Vincentddl/AerialRoboArm/Doc/hardware/JY61P_DIAGNOSTIC.md

# JY61P 独立诊断（2026-10-24）

## 2026-10-27 再次恢复 200Hz 的测试

后续用户拔下模块完成空载 PB6 测试，再重新连接后复测已恢复：9600 下只读查询得到一个有效应答，PB6 采样高 2018 次、低 2457 次、22 次变化。随后分步切到 115200，设置三类输出和 200Hz、98Hz 带宽，各流实测约 200～201Hz，校验和 UART 恢复均为零。日志：`outputs/jy61p_diagnostic/recover_200hz_reconnected_20261027.txt`。此时仍为独立诊断固件，尚未执行 EEPROM 保存或断电保持验证。下面为此次恢复前的失败记录。

用户要求单独测试能否恢复 200Hz。独立诊断固件烧录校验成功，HX8 不发送运动指令。

- 9600 下三类数据约 10Hz，无解析校验错误，无 UART 接收恢复。
- 只读寄存器查询完成发送，但 PB6 软件采样为 `high=4416 low=0 edges=0`，无有效寄存器应答。
- 显式尝试解锁、修改 BAUD=6 后，115200 下无有效数据、UART 恢复增加；诊断程序退回 9600，三类数据恢复约 10Hz。
- 本次没有恢复到 200Hz，没有发送保存/校准/零点指令。不能把 `sent=1` 当作配置成功。

日志：`outputs/jy61p_diagnostic/recover_200hz_20261027.txt`。现象与此前连接负载下 PB6 读回全高相似，当前供电方式正在向用户核实。尚未完成受控供电对照，因此不能唯一归因于电池或连接器。

## 最新复测：2026-10-25 已恢复

用户将模块换回 JY61P 后重测：9600 下三个数据流各 10Hz、无校验和 UART 恢复错误。硬件只读查询时 PB6 采样高 1955 次、低 2457 次、22 次变化，收到一个校验正确的寄存器应答，双向通信成立。

随后分步配置：115200 切换成功（仍为 10Hz）；仅 ACC/GYRO/ANGLE 输出配置成功；200Hz 设置后分别实测 200/201/200Hz；98Hz 带宽设置后为 200/200/200Hz，校验错误和 UART 恢复均为零。短时监测保持约 200Hz。

日志：`jy61p_replaced_scan_20261025.txt`、`jy61p_replaced_query_20261025.txt`、`jy61p_replaced_config_20261025.txt`。此前的外部拉高现象在本次连接状态下已不再出现，更支持接线/连接状态相关的问题；无法仅凭重插、换模块后的恢复断定最初的具体故障件。未执行 EEPROM 保存或断电保持验证。板上仍是独立诊断固件。

## 实机结果

- 只读扫描发现实际模块处于 **9600、10Hz**。每秒加速度、角速度、角度各 10 包，校验错误和 UART 接收恢复均为零。
- 115200 没有有效包，并出现频繁 UART 错误恢复。不能将这种状态简单等同于模块没有供电。
- 从 9600 发送解锁和 BAUD=6 指令，MCU 的发送接口返回成功，但 115200 没有有效反馈。切回 9600 可继续读取。
- 在 9600 发送无需解锁的寄存器查询，仍未收到预期校验正确的 0x55/0x5F 应答。

因此传感器到 MCU 的接收链路能工作；优先检查 **PB6/USART1_TX → 模块 RX** 的线序、接触和连续性。也可能是模块版本/协议或配置命令的生效方式，尚不能通过当前数据唯一定位，更不能断言模块已坏。供电在读取期间至少能维持传感器输出，但没有实测其电压及压降。

原始日志见 `outputs/jy61p_diagnostic/passive_scan_fixed.txt`、`config_steps.txt`、`register_query.txt`。其中早期诊断中错误波特率下的伪数据已在后续诊断中排除，不作为有效输出率。

## 诊断程序

独立构建 `cmake-build-jy61p-diagnostic`，配置 `HX8_JY60_CAPTURE=ON JY61P_CAPTURE=ON JY61P_DIAGNOSTIC=ON`。复用初始化和 USART1 DMA，但不进入 HX8 轮询或运动命令处理，不输出 PWM。RTT 9090 显示 `[DIAG]`，普通联合采集脚本应停止。

- `r`：只读扫描各波特率；候选必须无校验错误且无 UART 恢复，避免错误波特率下的伪匹配。
- `q`：在当前波特率查询寄存器并统计 0x5F 应答。
- `c`：明确触发分步配置；若新波特率不能确认则恢复本地主机 9600，不发送舵机命令。

当前板上为诊断固件，不接受 `g` 运动指令。恢复联合测试需要重新烧录 `cmake-build-hx8-jy61p-capture` 对应固件。

## 软件问题修正

排查同时发现，UART 错误中断重启 DMA 时，前台读函数可能用旧游标覆盖刚重置的接收游标。已增加恢复代数检查，丢弃发生这种竞争时的旧数据。联合固件启动扫描现在还检查 UART 恢复及校验错误，并实际确认波特率、速率，失败会打印明确原因并退回已识别波特率。过去 `sent=1` 仅代表发送成功，不能证明配置成功。

检查接线时先断电：确认主板原 ELRS 4 脚/PB6 到 JY61P RX 导通，3 脚/PB7 到 JY61P TX；不要把模块板上引脚序号与主板插座序号混为一谈。必要时用逻辑分析仪同时测 MCU PB6 与模块 RX，区分“没有发送波形”和“波形没送到模块”。

## 进一步双向通信实测

日志：`outputs/jy61p_diagnostic/bidirectional_test.txt` 和 `software_tx_test.txt`。

- 三次硬件 UART 只读查询，发送完成，但对 PB6 输入电平的高速软件采样均为 `tx_pin_low=0 tx_pin_edges=0`，无有效寄存器应答。
- USART1 的 PB6 AF 推挽配置和重映射寄存器读值与预期一致：GPIOB CRL `0x4B484444`、AFIO MAPR `0x02000004`、9600 的 BRR `0x1D4C`。
- 增加 `b` 命令：仅在本地 9600 下，将 PB6 暂时切到 GPIO 推挽，使用 DWT 周期计时发送同一个只读查询，再恢复 GPIO/USART 配置，不发送舵机指令。
- 两次 GPIO 模拟查询，每次 50 位中读到高电平 50 次、低电平 0 次，28 个要求为低的位读回不符；仍无寄存器应答。

上述是 MCU 数字输入读回结果，不是示波器波形或实际电压测量。优先怀疑 PB6 被外部拉高、接错引脚/短接，或主板引脚/配置异常。不能单凭本次结果断言 JY61P 损坏。

下一步：断电后仅断开 PB6→JY61P RX 线，保留传感器供电与 TX→PB7。重新上电，重复 PB6 查询测试。若低电平恢复，应优先排查外部线序、插座或模块 RX 端；若仍读回全高，应进一步检查 PB6 主板引脚、其他并接线路和 GPIO 配置，再决定是否更换硬件。此断线对照截至当前尚未完成。

## 整体插头拔下后的对照结果

用户说明连接器为一体座，无法单拆 RX 线，随后确认整个插头已拔下。新诊断 `p` 暂停 USART1，在 PB6、PB7 上依次输出高/低/高，再恢复原配置；无舵机控制。

- GPIOB 锁定寄存器为 0；PB6 和 PB7 输出配置均成功读回为推挽 GPIO `mode=0x3`。
- 两个引脚都得到 `expected=1 odr=1 idr=1` → `expected=0 odr=0 idr=0` → `expected=1 odr=1 idr=1`。
- 恢复 USART1 后，再发空载硬件串口查询，PB6 软件采样得到高 167 次、低 199 次、22 次边沿变化。外设配置下也能看到输出变化。

日志为 `unloaded_pin_test.txt`、`unloaded_uart_tx.txt`。与接上整只插头时 PB6 一直为高形成明确对照，优先定位外部线束、连接器线序或模块 RX 端的负载/短接问题。空载测试不能完全排除引脚带载能力异常，也不能单独区分线束与模块损坏；不应直接宣称 JY61P 芯片已坏。

下一步应断电核对主板原 ELRS 第 4 脚是否确实连接模块 RX，而非 VCC 或模块 TX。整个模块当前拔下，显示 0Hz 是预期现象；只有重新正确连接后才继续模块通信验证。
