Vincentddl/AerialRoboArm/Doc/design/05_HX8_OUTPUT_CURVE_PLAN.md

# HX8 主臂出力与运动曲线方案

## 适用范围与边界

本方案针对 HX8-U26H-M 经 UC-01 驱动主臂的单圈位置控制。当前项目的软件角度范围为 `-90°..+85°`，CH1 手动目标速度上限为 `150°/s`，发给舵机的速度上限为 `220°/s`，加减速时间各 `100 ms`。以下数值是**离线起始曲线**，尚未按实际负载标定，也未写入舵机。

厂家在 12 V 条件下给出的参考值：额定扭矩 `0.44 N·m`、最大连续扭矩 `1.18 N·m`、瞬时堵转扭矩 `2.55 N·m`、峰值电流 `5.5 A`；输入电压范围 `9.0..12.6 V`。连续持载以额定扭矩作为初始设计目标，堵转扭矩仅用于理解短时极限。

## 1. 先算负载，再选曲线

在机械臂最不利姿态估算关节静态扭矩：

`τ_joint ≈ 9.81 × Σ(质量_kg × 到转轴的水平距离_m)`。

若舵机与主臂之间的外部齿轮确为主动 `40` 齿、从动 `48` 齿，则初估舵机所需扭矩为 `τ_servo ≈ τ_joint / (1.2 × η)`；`η` 是传动效率，需结合装配实测。齿轮主动/从动方向、臂杆自重与负载重心必须确认后，才能给出可靠的负载上限。

## 2. 建议的速度—位置曲线

定义朝正角限位运动时 `d = 85° - 当前位置`，朝负角限位运动时 `d = 当前位置 + 90°`，即到目标方向软件限位的剩余角度；`u` 为 CH1 超过 `10%` 死区后归一化到 `0..1` 的幅度。先用下面两条曲线作为调试起点：

`v_空载 = min(150u, √(2 × 600 × d))  °/s`

`v_满载 = min(120u, √(2 × 400 × d))  °/s`

其中 `600` 和 `400` 的单位为 `°/s²`，是**计划中的保守减速能力**，须通过实测修正。目标方向指向限位时应用剩余距离 `d`；离开限位时按摇杆请求速度逐步加速。到 `d=0` 时速度命令为零，不再累积目标。舵机自身仍使用速度受限的位置指令，初期保持 `100 ms` 加速和 `100 ms` 减速。

| 距同侧限位 `d` | ≥20° | 10° | 5° | 2° | 0° |
| --- | ---: | ---: | ---: | ---: | ---: |
| 空载满杆上限 | 150 | 110 | 77 | 49 | 0 |
| 满载满杆上限 | 120 | 89 | 63 | 40 | 0 |

表中单位均为 `°/s`，只表示控制器的速度上限，不代表实测电机速度。若负载使跟踪误差持续增大，应降低该姿态的目标速度，而非让目标继续积累。

## 3. 功率与扭矩包络

当前运动指令的 `power_mw=0`，按厂家协议会采用舵机内部设定的功率保护值。此时把指令里的功率字段调大，不能越过内部保护值。先保持舵机原有保护设置，测得以下曲线后再决定是否要改：

- `P_hold(θ)`：不同角度连续保持时的功率，第 95 百分位值；
- `P_move(θ,v)`：不同角度和速度移动时的功率，第 95 百分位值；
- `I_peak(θ,v)`、`V_min(θ,v)`：加速与换向期间的峰值电流和最低电压；
- `e(θ,v)`：目标与编码器角度的跟踪误差。

若要为已知负载建立**低于舵机保护值**的运行功率包络，可从 `P_cmd(θ,v) = min(P_保护, 1.25 × P95_需求(θ,v))` 起步，并确认保持、启动和换向都能完成。`1.25` 是初始裕量，实际值由重复试验决定。任何温度、电流、功率或堵转保护触发时，停止运动并排查原因；不要仅靠提高保护阈值消除报警。需要提高舵机内部保护值时，先确认电源、线材、机构和连续热负荷承受能力，并查明原始配置及厂家允许范围。

## 4. 标定试验与验收

1. 分别以空载、预期负载的 50%、100% 试验；从小角度、小速度开始，确认机构无干涉。
2. 在 `-80°、-40°、0°、+40°、+80°` 附近分别做保持与往返运动，每种条件重复至少 5 次。暂不在负载下反复撞击 `-90°/+85°` 软件限位。
3. 记录至少 `10 Hz` 的编码器角度、目标角度、电压、电流、功率、温度原始值和状态位；短时电流峰值需用独立电流测量设备复核，因为 `10 Hz` 回读可能漏掉尖峰。
4. 在最不利的水平持载姿态连续保持至少 5 分钟，观察温升、位置下垂和电源压降。
5. 第一轮验收：全程电压处于 `9.0..12.6 V`，无堵转、欠压、过流、过功率、过温状态；稳态角度误差以 `≤2°` 为初始目标，且回中后目标不再继续积累。任何指标失败，都回到更低的速度或更小的负载重新标定。

最终曲线应以这组实测数据更新：将满足位置误差与温升要求的最大速度作为该角度、负载下的上限；功率配置只覆盖所需扭矩并保留可验证的裕量。没有负载质量、力臂和实测功率数据时，本文件中的数值不能作为已验证的出力承诺。

## 资料

- Fashion Star HX8-U26H-M 产品规格：<https://fashionstar.com.hk/wiki/uart-servo/hx8-u26h-m/>
- Fashion Star UART/RS-485 协议、功率字段及保护参数：<https://fashionstar.com.hk/wiki/protocols/servo/uart-rs485/>
- 项目当前限位与控制参数：`User/global/Inc/ara_def.h`、`User/mod/Inc/mod_rc_semantic.h`、`User/task/Inc/task_motion.h`。
