Vincentddl/AerialRoboArm/Doc/design/00_SYSTEM_CONSTITUTION.md

# docs/design v0

> **Archive note:** This design document belongs to the older BLDC/AS5600
> architecture narrative. It is kept for thesis/history reference only. The
> current hardware bring-up is documented in `Doc/hardware/pinmap.md`.

## 00_SYSTEM_CONSTITUTION.md

# AerialRoboArm 顶层宪法 v1.0

## 1. 文档定位
本文件是 AerialRoboArm（ARA）项目的顶层设计宪法。

本文件用于定义项目的第一身份、系统愿景、责任边界、控制主权与不可轻易违背的宏观设计原则。其目标不是描述某一版本的实现细节、模块完成度或阶段性进度，而是为后续架构设计、模块实现、状态机细化、接口收敛、联调验收与论文表述提供统一的上位依据。

凡属短期可变的版本状态、具体实现路径、暂定参数、阶段性工程负债与模块完成度，不应进入本文件正文，而应由运行时架构文档、模块契约文档、状态机文档、接口协议文档与版本说明文档承接。

## 2. 项目第一身份
ARA 的第一身份是**本科毕业设计样机**。

本项目首先服务于一套机载机械臂控制样机的设计、联调、验证与答辩表达，而非以通用机器人控制平台或成熟产品化控制器为直接目标。项目的一切架构选择，均应优先服从“样机可成立、主链路可联调、系统表述自洽、验证路径清晰”这一首要任务。

在此基础上，项目可以保留有限的可演进性，但这种可演进性是对样机价值的补充，而不是取代样机目标本身。

## 3. 项目愿景
ARA 旨在构建一套面向机载环境的轻量化机械臂控制子系统，在资源受限 MCU 上实现可运行、可观测、可联调、可实机验证的控制系统骨架。

该系统面向空中抓取类任务场景，试图在“平台载荷重量敏感”与“末端抓取动作对控制精度和响应速度提出较高要求”之间，建立一个工程上可成立的折中方案。系统以 STM32 为实时控制核心，以 BLDC 主轴闭环控制为动力基础，以舵机执行器承担末端姿态与夹取动作，以 RC 人工接管与视觉语义输入作为上层行为入口，形成一套在资源、时序、接口与业务逻辑上自洽的机载控制样机。

本项目当前不以复杂智能规划、整机飞控协同闭环或完整产品化鲁棒性为首要目标，而以建立一个“控制主链路清晰、系统边界明确、运行节拍可预测、调试与答辩可解释”的工程原型为首要目标。

## 4. 系统边界

### 4.1 系统性质
ARA 是**机载机械臂控制子系统**，不是无人机整机总控系统。

本系统负责机械臂相关的执行控制、模式管理、局部自治决策、RC 接管响应与视觉语义解释；本系统不负责飞行姿态控制、飞行航迹规划、平台接近目标的导航闭环与无人机整机级状态管理。

### 4.2 上游平台前提
ARA 默认挂载于一个能够维持基本稳定飞行状态的上游飞行平台上。平台接近目标、空中悬停稳定与基础姿态控制属于上游系统前提，而非本系统的直接闭环责任。

### 4.3 感知边界
视觉与测距系统的内部实现细节不属于本电控系统的职责边界。对于 ARA 电控系统而言，感知链路最终应被抽象为**统一扩展链路上的最终语义事件输入**。系统不依赖单目视觉、ToF、深度估计或融合算法的内部实现过程，而只依赖它们最终输出的、对机载决策直接有意义的紧凑语义结果。

### 4.4 决策边界
PC/地面端或其上的感知系统负责环境感知与事件计算；机载 STM32 负责结合本机当前模式、主轴状态与业务状态机，完成最终动作决策与执行控制。感知端不直接承担执行器闭环控制职能。

## 5. 控制主权与模式哲学

### 5.1 控制主权分配
ARA 的控制主权分配遵循以下原则：
- RC 是人工接管入口，具备最高即时接管优先级；
- 视觉链路是环境语义输入入口，不直接拥有执行器闭环控制权；
- STM32 是机载最终决策与执行节点，负责在当前模式约束下将输入语义转化为动作输出。

### 5.2 Manual 模式
在 MANUAL 模式下，自动决策逻辑必须挂起。系统允许视觉事件继续接收与更新，但视觉信息在该模式下不作为动作主导来源。此时系统的主轴、姿态与夹爪动作均以 RC 语义输入为唯一有效控制来源。

### 5.3 Auto 模式
在 AUTO 模式下，系统接收由感知链路回传的最终视觉语义事件，并由机载 STM32 结合当前自身状态完成动作决策。AUTO 模式的目标是实现**受监督的局部自治**，而不是构建脱离人工接管能力的完全自主系统。

### 5.4 模式优先级
凡 RC 接管、急停请求或系统关键模式转换与 AUTO 业务状态机发生冲突时，应优先服从人工接管与系统安全相关的高优先级约束。

## 6. 宏观设计原则

### 6.1 资源约束优先
一切设计必须首先服从 STM32F103C8T6 的 RAM、算力、定时器、DMA、串口与总线资源边界。任何为追求形式上的架构完整性而破坏资源可承受性的设计，都应被视为无效设计。

### 6.2 时序确定性优先
系统必须优先保证控制链路的运行时可预测性。高频控制路径不得因阻塞式 IO、复杂日志格式化、动态资源竞争、跨模块隐式依赖或不受控的多线程交互而失去确定性。

### 6.3 分层与职责单一
系统采用分层设计。每一层只承担与其层级相称的职责：
- 底层负责外设与硬件抽象；
- 中层负责驱动、算法与功能模块封装；
- 任务层负责业务 runnable 与状态机；
- 顶层负责物理线程容器与系统调度。

任何跨层越权行为，若会破坏职责边界，应被视为架构退化。

### 6.4 单向数据流优先
高频控制域与低频业务域之间的跨线程信息交换，必须通过统一的数据桥梁完成。业务模块之间不应通过横向读取彼此内部状态形成隐式耦合。系统应优先维持“输入—决策—执行—反馈”的清晰方向性。

### 6.5 语义先于实现
任何关键术语在进入代码实现前，必须先具有稳定且唯一的设计语义。例如：系统模式、动作目标、急停、对齐、归位、机械原点、电角参考、抓取判据等概念，必须先在设计层定义，再在实现层映射。

### 6.6 紧凑语义优先于原始数据堆积
统一扩展链路优先承载对机载控制决策直接有意义的紧凑语义结果，而非大规模原始感知数据。任何外部输入若不能被压缩为对控制链路直接有用的事件或参数，就不应直接进入核心控制体系。

## 7. 控制对象划分原则
ARA 的控制对象分为两类：

### 7.1 高频闭环对象
BLDC 主轴是当前系统唯一的高频闭环执行对象。与主轴位置、速度、对齐、归位和闭环控制相关的控制逻辑，应被视为系统动力核心。

### 7.2 低频直控对象
夹爪舵机与姿态舵机属于低频直控执行对象。它们承担末端动作与姿态调节功能，但不构成当前版本的统一高频闭环控制核心。

这一划分是系统资源约束与任务目标共同作用下的工程选择，而非临时性的实现妥协。

## 8. 当前阶段的战略目标
当前阶段的战略目标是：**优先建立 Happy Path 可成立、主链路可联调、样机行为可解释的控制系统原型。**

这意味着，当前阶段优先验证以下方面：
- 核心控制架构是否成立；
- 主轴控制链路是否能够完成对齐、归位、闭环与手动控制；
- Manual / Auto 模式切换与控制主权分配是否自洽；
- 感知语义输入到动作输出的主业务流是否可联调；
- 系统在答辩与工程表述上是否具有清晰的结构与边界。

当前阶段不以完整异常流覆盖、产品级容错体系、复杂自主规划能力或全链路产品化成熟度作为首要验收目标。

## 9. 非目标声明
在当前阶段，下列方向不作为首要设计目标：
- 无人机整机级飞控闭环与导航协同；
- 高自由度多执行器统一高频闭环；
- 完整产品化高可靠容错与恢复体系；
- 对感知算法内部细节的深度耦合；
- 脱离人工接管能力的完全自主抓取系统。

上述方向在后续研究或扩展中可被讨论，但不构成本文件所约束的当前项目核心目标。

## 10. 文档优先级
当不同文档、注释或临时讨论之间出现冲突时，应遵循以下优先级：
1. 顶层宪法；
2. 运行时架构、模块契约、状态机、接口协议等正式设计规范；
3. 代码头文件注释；
4. 分支说明、阶段复盘、开发记录；
5. 临时讨论结论。

凡与本宪法冲突的实现细节、临时约定或局部设计，应以修正实现或补充正式设计文档为优先，而不应反向削弱顶层原则。
