Vincentddl/AerialRoboArm/Core/Src/main.c

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
/* Includes ------------------------------------------------------------------*/
#include "main.h"
#include "cmsis_os.h"
#include "dma.h"
#include "i2c.h"
#include "iwdg.h"
#include "tim.h"
#include "usart.h"
#include "gpio.h"

/* USER CODE BEGIN Includes */
#include "bsp_uart.h"
#include "bsp_gpio.h"
#include "bsp_pwm.h"

/* demo_v7 app-layer entries */
#include "app_control.h"
#include "app_debug.h"
#include "app_jy60_demo.h"
#include "app_hx8_jy60_capture.h"

/* USER CODE END Includes */


void SystemClock_Config(void);
void MX_FREERTOS_Init(void);
/**
  * @brief  The application entry point.
  * @retval int
  */
int main(void)
{

  /* MCU Configuration--------------------------------------------------------*/

  /* Reset of all peripherals, Initializes the Flash interface and the Systick. */
  HAL_Init();

  /* Configure the system clock */
  SystemClock_Config();

  /* Initialize all configured peripherals */
#if defined(HX8_JY60_CAPTURE)
  MX_GPIO_Init();
  MX_DMA_Init();
  MX_USART1_UART_Init();
  MX_USART2_UART_Init();
  MX_IWDG_Init();
  App_Hx8Jy60Capture_Run();
#elif defined(JY60_UART_DEMO)
  /* Sensor-only path: no PWM, HX8 UART, HC13, control tasks or homing. */
  MX_GPIO_Init();
  MX_DMA_Init();
  MX_USART1_UART_Init();
  MX_IWDG_Init();
  App_Jy60Demo_Run();
#else
  MX_GPIO_Init();
  MX_DMA_Init();
  MX_I2C1_Init();       /* PB8/PB9 sensor bus; VL53L1X uses address 0x29. */
  MX_USART3_UART_Init();  /* HC13 transparent UART on PB10/PB11. */
  MX_TIM2_Init();
  MX_USART1_UART_Init();
  MX_USART2_UART_Init();
  MX_IWDG_Init();
  /* USER CODE BEGIN 2 */
    BSP_UART_Init(); // 确保串口先初始化，方便打印 Log
#if !defined(TOFSENSE_SAFE_TEST)
    /* Sensor-only validation must not start either PTK PWM output. */
    BSP_PWM_Init();
#endif

    /* PB8/PB9 provide the I2C1 sensor bus. */

    /* demo_v7: bring up app-layer dependencies before kernel starts. The
     * actual ControlTask / DebugTask are created from RTOS_THREADS in
     * freertos.c. */
    App_Control_InitDeps();
    App_Debug_InitDeps();

  /* USER CODE END 2 */

  /* Init scheduler */
  osKernelInitialize();  /* Call init function for freertos objects (in cmsis_os2.c) */
  MX_FREERTOS_Init();

  /* Start scheduler */
  osKernelStart();

  /* We should never get here as control is now taken by the scheduler */

  /* Infinite loop */
  /* USER CODE BEGIN WHILE */
  while (1)
  {
    /* USER CODE END WHILE */

    /* USER CODE BEGIN 3 */
  }
  /* USER CODE END 3 */
#endif
}

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
/**
  * @brief  Period elapsed callback in non blocking mode
  * @note   This function is called  when TIM4 interrupt took place, inside
  * HAL_TIM_IRQHandler(). It makes a direct call to HAL_IncTick() to increment
  * a global variable "uwTick" used as application time base.
  * @param  htim : TIM handle
  * @retval None
  */
void HAL_TIM_PeriodElapsedCallback(TIM_HandleTypeDef *htim)
{
  if (htim->Instance == TIM4)
  {
    HAL_IncTick();
  }
}

/**
  * @brief  This function is executed in case of error occurrence.
  * @retval None
  */
void Error_Handler(void)
{
  /* USER CODE BEGIN Error_Handler_Debug */
  /* User can add his own implementation to report the HAL error return state */
  __disable_irq();
  while (1)
  {
  }
  /* USER CODE END Error_Handler_Debug */
}
#ifdef USE_FULL_ASSERT
/**
  * @brief  Reports the name of the source file and the source line number
  *         where the assert_param error has occurred.
  * @param  file: pointer to the source file name
  * @param  line: assert_param error line source number
  * @retval None
  */
void assert_failed(uint8_t *file, uint32_t line)
{
  /* USER CODE BEGIN 6 */
  /* User can add his own implementation to report the file name and line number,
     ex: printf("Wrong parameters value: file %s on line %d\r\n", file, line) */
  /* USER CODE END 6 */
}
#endif /* USE_FULL_ASSERT */
