Vincentddl/AerialRoboArm/standalone/vl53l3cx_f103/App/Inc/app_config.h

#ifndef APP_CONFIG_H
#define APP_CONFIG_H

#define VL53L3CX_I2C_ADDRESS_8BIT 0x52U
#define SENSOR_I2C_CLOCK_HZ 400000U
#define VL53L3CX_POLL_PERIOD_MS 2U
#define VL53L3CX_RETRY_PERIOD_MS 1000U
#define VL53L3CX_PRINT_DECIMATION 1U

#define DEBUG_UART_BAUDRATE 115200U
#define DEBUG_UART_TIMEOUT_MS 100U

#endif
