Vincentddl/AerialRoboArm/standalone/vl53l3cx_f103/Core/Inc/i2c.h

#ifndef __I2C_H
#define __I2C_H

#ifdef __cplusplus
extern "C" {
#endif

#include "main.h"

extern I2C_HandleTypeDef hi2c1;

void MX_I2C1_Init(void);

#ifdef __cplusplus
}
#endif

#endif /* __I2C_H */
