Vincentddl/AerialRoboArm/standalone/vl53l3cx_f103/Core/Inc/usart.h

#ifndef __USART_H
#define __USART_H

#ifdef __cplusplus
extern "C" {
#endif

#include "main.h"

extern UART_HandleTypeDef huart2;

void MX_USART2_UART_Init(void);

#ifdef __cplusplus
}
#endif

#endif /* __USART_H */
