Vincentddl/AerialRoboArm/standalone/vl53l3cx_f103/Core/Src/gpio.c

#include "gpio.h"
#include "main.h"

void MX_GPIO_Init(void)
{
    GPIO_InitTypeDef GPIO_InitStruct = {0};

    __HAL_RCC_GPIOC_CLK_ENABLE();
    __HAL_RCC_GPIOA_CLK_ENABLE();
    __HAL_RCC_GPIOB_CLK_ENABLE();

    HAL_GPIO_WritePin(LED_GPIO_Port, LED_Pin, GPIO_PIN_SET);
    HAL_GPIO_WritePin(VL53_XSHUT_GPIO_Port, VL53_XSHUT_Pin, GPIO_PIN_RESET);

    GPIO_InitStruct.Pin = LED_Pin;
    GPIO_InitStruct.Mode = GPIO_MODE_OUTPUT_PP;
    GPIO_InitStruct.Speed = GPIO_SPEED_FREQ_LOW;
    HAL_GPIO_Init(LED_GPIO_Port, &GPIO_InitStruct);

    GPIO_InitStruct.Pin = VL53_XSHUT_Pin;
    GPIO_InitStruct.Mode = GPIO_MODE_OUTPUT_PP;
    GPIO_InitStruct.Pull = GPIO_NOPULL;
    GPIO_InitStruct.Speed = GPIO_SPEED_FREQ_LOW;
    HAL_GPIO_Init(VL53_XSHUT_GPIO_Port, &GPIO_InitStruct);

    GPIO_InitStruct.Pin = VL53_GPIO1_Pin;
    GPIO_InitStruct.Mode = GPIO_MODE_INPUT;
    GPIO_InitStruct.Pull = GPIO_PULLUP;
    HAL_GPIO_Init(VL53_GPIO1_GPIO_Port, &GPIO_InitStruct);
}
