Vincentddl/AerialRoboArm/standalone/vl53l4cd_f103/App/Inc/app_config.h

#ifndef APP_CONFIG_H
#define APP_CONFIG_H

#define VL53L4CD_I2C_ADDRESS_8BIT 0x52U
#define SENSOR_I2C_CLOCK_HZ 400000U
#define VL53L4CD_TIMING_BUDGET_MS 20U
#define VL53L4CD_APP_INTERMEASUREMENT_MS 0U
#define VL53L4CD_POLL_PERIOD_MS 1U
#define VL53L4CD_RETRY_PERIOD_MS 1000U
#define VL53L4CD_PRINT_DECIMATION 1U

#define DEBUG_UART_BAUDRATE 115200U
#define DEBUG_UART_TIMEOUT_MS 100U

#endif
