Vincentddl/AerialRoboArm/(commit log)

2026-03-06 Improve FOC stability and fix test console encoding
    降低了编码器 I2C 读数在闭环下报 -2 / -10 的概率
    避免了日志打印干扰 PID 内部状态
    避免了闭环模式里反复初始化 PWM/驱动导致的抖动
    把 c 模式从过激设置改成更保守、可调试的状态
    修复了 FOC 波形查表 bug
    解决了 test_console.c 的中文注释乱码问题
    [i2c.c, test_console.c]
2026-03-06 完善I2C恢复逻辑并优化闭环测试流程
    完善 AS5600 的 I2C/DMA 错误恢复机制
    优化 test_console 模式切换与停机逻辑
    增加 Uq 斜坡控制并重新整定 2808 测试参数
2026-03-28 串口调试窗口（USART3, 115200 baud）无法输入任何字符，按键后控制台无响应。
    ### 根因分析
    **根因 1（主要）：UART 错误后 DMA 接收永久停止**
    STM32 HAL 在检测到 UART overrun 错误时，内部调用链
    `USART3_IRQHandler → HAL_UART_IRQHandler → UART_DMAError → HAL_DMA_Abort`
    会中止 DMA 传输并将 UART 状态置为 READY，导致 DMA 接收永久停止。
    项目中缺少 `HAL_UART_ErrorCallback`，错误发生后无任何恢复机制。
    **根因 2（次要）：命令需要换行符才触发**
    `ProcessConsoleByte` 只在收到 `\r`/`\n` 时才执行命令。使用 raw 模式终端时，按键只发送单字节（如 `0x7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
2026-05-06 修复电机 testbench 真实对齐与闭环方向
    本次修改修复电机 testbench 的 FOC 对齐和闭环控制路径，去掉硬编码零点，改为使用运行时真实对齐结果，并修正闭环力矩方向。
    改动内容：
    - 删除 app_testbench.c 中的硬编码 FOC 零点注入。
    原代码固定注入 TB_MOTOR_HARDCODED_ZERO_OFFSET = 887，并直接把 aligned 置为 true，导致系统跳过真实对齐。该固定值不匹配当前硬件位置，会导致 FOC 电角度错误。
    - 初始化时将电机状态设为未对齐。
    aligned 现在初始化为 false，闭环/开环在真实对齐完成前不会运行，避免使用无效零点进入控制。
    - 进入 slot 1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
    [app_testbench.c]
2026-05-14 feat(demo_v7): phase1 dual-link + ST3215 protocol skeleton
    Build a complete control stack for the dual-input ST3215 era while keeping
    the legacy BLDC code intact (excluded from build).
    L5 Application threads:
    - app_control: 50 Hz ControlTask, sole DataHub writer, with bring-up
    state machine (BOOT -> SERVO_PING -> SERVO_CONFIG -> SERVO_ENABLE
    -> RUNNING -> FAULT) and heartbeat for IWDG.
    - app_debug: 10 Hz console + LED renderer + DataHub snapshot dump.
    - app_housekeeping: 1 Hz, runs from defaultTask body, refuses to feed
    IWDG when ControlTask heartbeat is stale.
    L4 Task runnables:
    - task_arbiter: pure function E-Stop / MANUAL / AUTO / link-loss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
2026-05-14 chore(demo_v7): remove legacy BLDC/FOC stack
    Phase 1 build has been validated with these files excluded via CMake
    EXCLUDE REGEX. Now that the new ST3215 + Mock stack compiles and links
    cleanly at 14.2 KB RAM / 50.3 KB FLASH, the legacy files have no further
    reference and can be git-rm'd.
    Removed:
    User/mod/{alg_pid,alg_voltage_foc}.{h,c}
    User/drv/{drv_as5600,drv_bldc_power}.{h,c}
    User/bsp/{bsp_i2c}.{h,c}
    CMakeLists.txt: drop the matching EXCLUDE REGEX entries. Remaining
    EXCLUDEs (app_threads, app_testbench, test_console_drvtest) are kept
    for Phase 2, where their useful migration content moves into app_debug
    and ST3215-specific test slots before deletion.
    Resource (unchanged): RAM 142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
2026-05-14 chore(demo_v7): wire USART2 HD path after CubeMX regen
    CubeMX configuration update:
    - USART2 enabled at 1 Mbps Single Wire (Half Duplex), DMA TX=DMA1_Ch7,
    DMA RX=DMA1_Ch6, NVIC priority 5 (compatible with FreeRTOS
    configMAX_SYSCALL_INTERRUPT_PRIORITY).
    - IWDG enabled at LSI/64, reload 2812 (~4.5 s window). Feeds via
    app_housekeeping which gates on a fresh ControlTask heartbeat.
    - TIM1 disabled (3-phase PWM no longer used). I2C1 disabled
    (AS5600 path retired).
    - FreeRTOS heap synced to 5120 in .ioc (matches FreeRTOSConfig.h).
    - configCHECK_FOR_STACK_OVERFLOW = Method 2 enabled in .ioc.
    CubeMX regen reconciliation:
    - CMakeLists.txt: restore User/*.* glob and 6 User include roots
    tha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
    [FOC_DEMO2.ioc, bsp_pwm.c, bsp_pwm.h, bsp_uart.c, i2c.c, main.c, usart.c, usart.h]
2026-05-14 feat(demo_v7): wire torque_enable into real motion path
    Previously the real-servo path could only WritePos and ReadFeedback,
    so when the manipulator FSM commanded torque_on=true the servo would
    not actually exert force unless its TORQUE_ENABLE register happened
    to be set out-of-band.
    Changes (real path only, MOCK path untouched):
    - Add do_set_torque() built on do_write_byte() with the existing
    ACK parse path.
    - TaskMotion_Update now sequences set-torque BEFORE write-pos when
    cmd->torque_on disagrees with the cached s_torque_enabled flag.
    - If torque-enable IO fails, the WritePos call is suppressed for
    this tick; last_write_result carries the failure code upward.
    - When torque is relea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
    [task_motion.c]
2026-05-14 fix(demo_v7): pre-bringup correctness for ST3215 path
    Two latent issues spotted in code review before flipping
    TASK_MOTION_USE_MOCK to 0 on real hardware.
    1. task_motion deadband narrowing trap
    The deadband check used (int16_t)(target - last) where last is
    seeded with INT16_MIN. The subtraction itself is safe because
    int16_t promotes to int, but the cast back to int16_t turns 32768
    into INT16_MIN (implementation-defined narrowing) and abs() on the
    result is undefined for INT16_MIN.
    Practical impact: the very first WritePos after boot or after
    torque-release could be misclassified as 'unchanged' and skipped
    until the keepalive timer fires, delaying the first motion by up
    to TASK_MOTION_KEE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
    [task_motion.c]
2026-05-14 chore(demo_v7): pre-bringup hardening (sentinel + step_config doc)
    Two pre-bringup polish items, no behavior change for the
    exercised paths.
    A. step_config: keep as no-op pass-through, document why
    The prior comment 'real-servo configuration would go here' read like
    an unfinished TODO. In practice, full validation (read MODE / MIN /
    MAX / TORQUE_LIMIT and compare against expected) would require new
    encode/parse helpers in drv_st3215, plus a policy decision on
    auto-rewriting EEPROM (which has limited write cycles).
    For demo_v7 the policy is: physically inspect or set EEPROM via the
    vendor utility once before first power-up. The PING phase already
    runs one torque-off WritePos + ReadFeedback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
2026-05-14 feat(demo_v7): force-step bring-up tool for ST3215 closed-loop test
    Adds an operator-driven 'force mode' that bypasses Arbiter and
    Manipulator and drives TaskMotion_Update directly. Purpose is to
    let bring-up validate the full closed-loop verification path
    (input -> WritePos -> servo internal PID -> ReadFeedback -> debug
    print) without any policy layer in between.
    Why force mode rather than going through the Arbiter MANUAL slot:
    - ELRS Tx is not yet on hand. Arbiter Rule 3 would estop on
    is_link_up=false and we'd never reach a real motion command.
    - Bringing up the motor needs the shortest possible path. Force
    mode short-circuits everything between the keyboard and ST3215
    so a fault i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
    [app_control.c, app_debug.c, debug_request.h]
2026-05-15 feat(demo_v7): ST3215 真机首次闭环 bring-up 通过
    完成 demo_v7 phase1 第一次物理闭环验证：通过调试串口按键
    驱动 ST3215 总线舵机，看到 pos 朝 tgt 收敛。本次涉及 CubeMX
    切换、Mock 关闭、调试体验微调以及若干代码风格修正。
    CubeMX：USART2 半双工 → 全双工
    - PA2 由 Half_duplex 改为 Asynchronous TX，新增 PA3 作为独立 RX
    - HAL_HalfDuplex_Init() 改为 HAL_UART_Init()
    - bsp_uart 的 '发完再收' 时序与全双工/半双工无耦合，保留不动
    接口名带 HD 前缀只是 cosmetic 失准
    task_motion.h：开关切到真实路径
    - TASK_MOTION_USE_MOCK 默认值 1 → 0
    bring-up build 走真实 ST3215 IO；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
    [FOC_DEMO2.ioc, app_control.c, app_debug.c, task_arbiter.c, task_motion.c, task_motion.h, usart.c]
2026-05-16 feat(demo_v7): ST3215 迁移至 FSUS (HX8-U26H-M) 总线舵机协议
    协议层:
    - 新建 drv_fsus.c/h: Fashion Star UART Servo 协议编解码
    - 帧头 0x4C12/0x1C05, checksum = sum & 0xFF (非取反)
    - 实现 Ping / SetAngleByVelocity / QueryAngle / ServoMonitor / Stop
    - 新建 drv_h13.c/h: HC-13 蓝牙透传驱动(未接线,预置)
    - 修复 checksum 算法: ~sum → sum (P0 致命 bug,原因帧被舵机拒绝)
    硬件层:
    - USART2 从半双工 DMA 改为全双工中断 RX + 阻塞 TX
    - bsp_uart 新增 FSUS API: Send / Recv / Flush
    - USART2 波特率 1M → 115200
    - CMakeLists 修复: CubeMX 覆盖后补回 User include + GLOB + EXCLUDE
    任务层:
    - task_motion.h/c 重写: MotionCmd/Motion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
    [FOC_DEMO2.ioc, app_control.c, bsp_uart.c, bsp_uart.h, drv_fsus.c, drv_fsus.h, task_arbiter.c, task_manipulator.c]
2026-05-17 fix(demo_v7): FSUS bring-up 全套修复, HX8 真机闭环通过
    致命 bug 修复:
    - task_motion.c::fsus_transact 帧长 +1U 多算 1 字节, 致使
    ServoMonitor 永远超时(舵机只发 5+size, 多读的字节永远不到达).
    - fsus_transact 内 spin polling 在舵机不响应时占满 CPU 100ms,
    ControlTask 优先级高于 defaultTask, 喂狗任务被饿死, IWDG 4.5s
    reset, 表现为串口反复打印启动 banner. 三处 polling 加 osDelay(1)
    让出 CPU, 同时保留 deadline 兜底.
    坐标系统一:
    - 整条数据流改为 FSUS 原生 -180..+180 度域, 删除 0..359 → -180..+180
    的 wrap 映射(map_angle_to_fsus 现在只 clamp).
    - TASK_MOTION_ANGLE_MIN/MAX_DEG 0/359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
    [app_debug.c, bsp_uart.c, bsp_uart.h, task_arbiter.c, task_motion.c, task_motion.h]
2026-05-20 feat(demo_v7): 两步复位安全语义 + ELRS DMA 自愈 + 真机 bring-up 与 PTK 末端舵机驱动
    整套改动跨越 L2(BSP)/L3(MOD)/L4(Task)/L5(App) 四层, 完成两件事:
    1. 把 RC + 仲裁层升级为符合工业安全惯例的"两步复位"安全语义
    2. 把主臂 HX8 总线舵机与末端 PTK 7350MG-D 普通舵机这两条执行链路
    全部接通到真机, 取代 demo_v7 早期为冷启动留的 mock motion
    ================================================================================
    L4 仲裁层重构: 两步复位安全语义
    ================================================================================
    背景动机:
    - 旧 arbiter 是一步式恢复——SD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
2026-05-21 feat(demo_v7): PTK 末端小舵机 bench 测试链路 + 调试增强
    本次主题：让操作员能在 HX8 主臂未通电的情况下，仅用 ELRS 遥控器 +
    PA0/PA1 PTK 小舵机做端到端 bring-up，并在串口上直接看到送给小舵机
    的角度值。配套修复了 PWM 上电中位、CH2 中位抖动等真机暴露的问题。
    1. bench 测试模式（临时开关，默认 ON 用于当前测试阶段）
    task_motion.h:
    新增 TASK_MOTION_SKIP_PING_FOR_BENCH 编译开关，当前=1。
    宏注释明确说明：仅供 PA0/PA1 桌面台架测试，禁止在主臂上电时使能，
    回归飞行 bring-up 前必须改回 0。
    app_control.c::step_ping:
    bench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
    [app_control.c, app_debug.c, bsp_pwm.c, datahub.h, task_motion.c, task_motion.h]
2026-05-21 @ perf(demo_v7): HX8 主臂协议极限提速 + SB 复位 seed 当前角度
    - CH1 步进: 8°/40ms(200°/s) → 15°/20ms(750°/s)，累加器吃满 50Hz 控制周期
    - FSUS 舵机参数: VEL=300→750(协议上限), T_ACC=100→20ms(协议下限),
    T_DEC=100→20ms, POWER=1000→0(舵机自算)
    - SB 复位后 CH1 累加器 no longer 写死 0，改为 seed 到舵机当前物理角度，
    避免进 MANUAL 自动回零跳变
    - 关闭 bench 模式 (TASK_MOTION_SKIP_PING_FOR_BENCH 1→0)
    @
    [app_control.c, task_motion.h]
2026-05-26 @ refactor(demo_v7): 夹爪通道 CH2 → CH4，消除 CH1/CH2 摇杆物理串扰
    - MOD_RC_IDX_CH2(1U) → MOD_RC_IDX_CH4(3U)，夹爪从 CH2 换到 CH4
    - MOD_RC_CH2_CENTER_DEADBAND_RAW → MOD_RC_CH4_CENTER_DEADBAND_RAW
    - app_debug raw dump 标签 CH2→CH4，索引 ch[1]→ch[3]
    - datahub.h / mod_rc_semantic.h 注释同步更新
    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
2026-05-27 @ feat(demo_v7): PTK 7462W 小舵机适配 + H13 视觉协议栈 + Flash 优化 + 调试增强
    1. newlib-nano 切换（CMakeLists.txt）
    - 编译和链接同时加 --specs=nano.specs, User/ 代码中无浮点
    printf 使用, 完整 newlib 的 _svfprintf_r/_dtoa_r/双精度软浮点
    /dlmalloc 等 ~22 KB 被自动裁剪, Flash 从 84.2% 降至 ~50%
    2. PTK 7462W 数字舵机适配（bsp_pwm.c / drv_servo.c）
    - 上电预加载脉宽 1500→1520µs, 匹配 7462W 中位标称值
    - 角度→脉宽映射改为分段线性: 0°→500µs, 90°→1520µs, 180°→2500µs
    下半区 Pulse=500+angle×34/3, 上半区 Pulse=1520+(angle-90)×98/9
    3. PTK 末端舵机独立 force 控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
2026-06-04 @ chore: .gitignore 忽略 .claude/ 和 stm32f1_stlink.cfg
    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
2026-06-07 feat(debug): 接入 DAPLink OpenOCD RTT 调试通道
    将原先占用 USART3 的调试控制台迁移到 SEGGER RTT channel 0，并通过 DAPLink + OpenOCD RTT server 暴露为本地 TCP 端口，供 VOFA+/PuTTY 等工具查看日志和发送调试命令。
    主要变更：
    - 新增 SEGGER RTT 基础组件：SEGGER_RTT.c、SEGGER_RTT.h、SEGGER_RTT_Conf.h、SEGGER_RTT_ConfDefaults.h
    - 将 BSP_UART_Printf() 从 USART3 DMA 输出切换为 SEGGER_RTT_Write(0, ...)
    - 将 DebugTask 控制台输入从 BSP_UART_Read(BSP_UART_DEBUG, ...) 切换为 SEGGER_RTT_Read(0, ...)
    - 停用 main.c 中的 MX_USART3_UART_Init()，释放 USART3 外设资源，后续可用于 H13 或其他串口设备
    - 移除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
    [daplink_rtt.cfg]
2026-06-25 docs: record RTT and BOOT0 troubleshooting
    [daplink_rtt.cfg, daplink_rtt_server.cfg]
2026-06-25 docs: archive legacy drivers and update hardware notes
2026-06-26 记录总线舵机联调并稳定 RTT 流程
    [daplink_rtt_attach.cfg]
2026-06-29 优化舵机响应与上电归零控制
2026-06-30 优化 HX8 手动控制响应
2026-08-17 feat: harden arm control and HC13 vision link
    - add bidirectional HC13 acknowledgements and a DTR-safe link test tool
    - enforce safer startup, handoff and mechanical angle limits
    - add ToF sensor groundwork plus DAPLink/J-Link flash and RTT tooling
    [daplink.cfg, jlink.cfg, jlink_rtt.cfg, jlink_rtt_attach.cfg, jlink_rtt_server.cfg]
2026-08-18 feat: tune manual motion and auto gripper defaults
    - run HX8 manual motion at the 696 deg/s rated command speed
    - open the PTK gripper to 130 degrees throughout AUTO mode
    - change RTT presets 2 and 3 to -70 and +70 degrees
2026-08-31 fix: 修复HX8通信延迟、重连猛转与堵转保护
    - 按协议加入5ms帧间隔并缩短回读阻塞时间
    - 增加USART2接收自愈、发送错误与总线诊断计数
    - 冻结离线目标，重连后等待摇杆回中并保持编码器位置
    - 锁存堵转故障，重复发送停止命令并屏蔽后续运动
    - 将手动速度调整为300度每秒并增加中文修复日志
    [app_control.c, app_debug.c, bsp_uart.c, bsp_uart.h, datahub.h, drv_fsus.h, main.c]
2026-10-03 backup: snapshot firmware and sensor tools (2026-10-04)
    [TOFSense_F2P_F103_STLinkV2.cfg, VL53L3CX_F103_STLinkV2.cfg, VL53L4CD_F103_STLinkV2.cfg, daplink_rtt.cfg, daplink_rtt_attach.cfg, daplink_rtt_server.cfg, stlink.cfg, stm32f1_stlink_rtt_server.cfg]
2026-10-06 Set main-arm angle limits to -90..85 degrees
2026-10-19 Add VOFA manual control without ELRS and servo debug modes
2026-10-30 Back up HX8 JY61P capture tools and HC13 host protocol specification
    Add standalone JY60/JY61P capture and diagnostics, timestamped RTT recording, manual zero recovery, parser tests, and hardware/vision documentation.
    HC13 host protocol V1 is a specification only; the new host commands are not implemented in firmware. Preserve binary documentation artifacts without text conversion.
    Validation: regular and joint-capture firmware builds; native capture-command, IMU-parser, startup/home and both AUTO-grip tests; 21 Python capture/HC13 tests.
